Jed0vcela/MacroPicoV1/3D files/encoder handle.SLDPRT

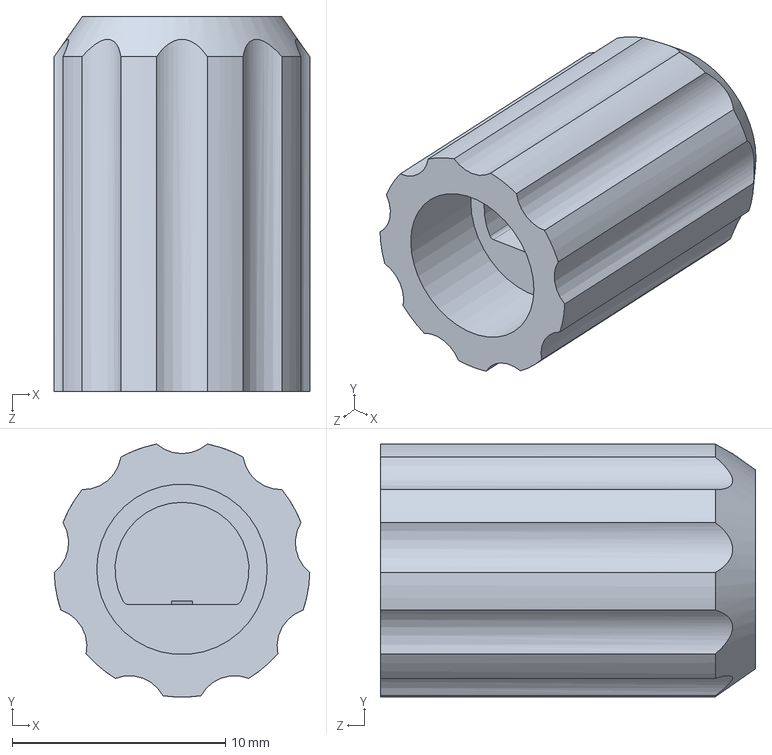
[picture p1: CAD file, 2025-07-16]
3D files/encoder handle.SLDPRT
12.0 x 11.9 x 17.6 mm
