Jed0vcela/MacroPicoV1/3D files/case bottom^Error2025Assem2.STL

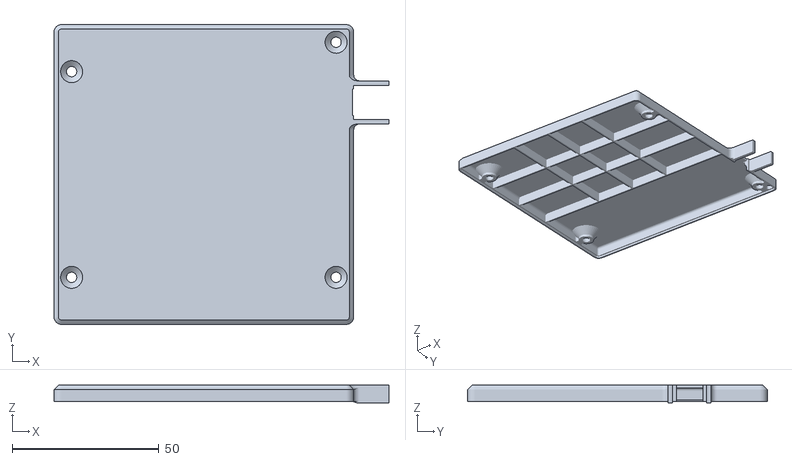
[picture p2: CAD file, 2025-07-16]
3D files/case bottom^Error2025Assem2.STL
114.0 x 102.0 x 6.00
