Jed0vcela/MacroPicoV1/3D files/switch soldering holder.SLDPRT

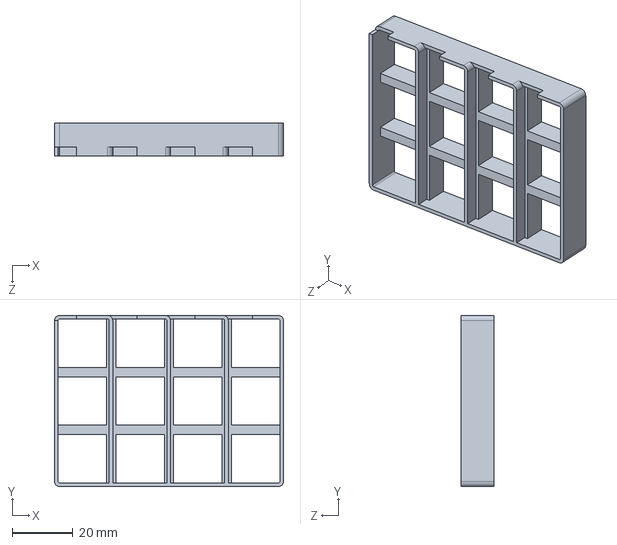
[picture p3: CAD file, 2025-07-16]
3D files/switch soldering holder.SLDPRT
75.5 x 56.5 x 11.0 mm
