Jed0vcela/MacroPicoV1/3D files/usb cable.SLDPRT

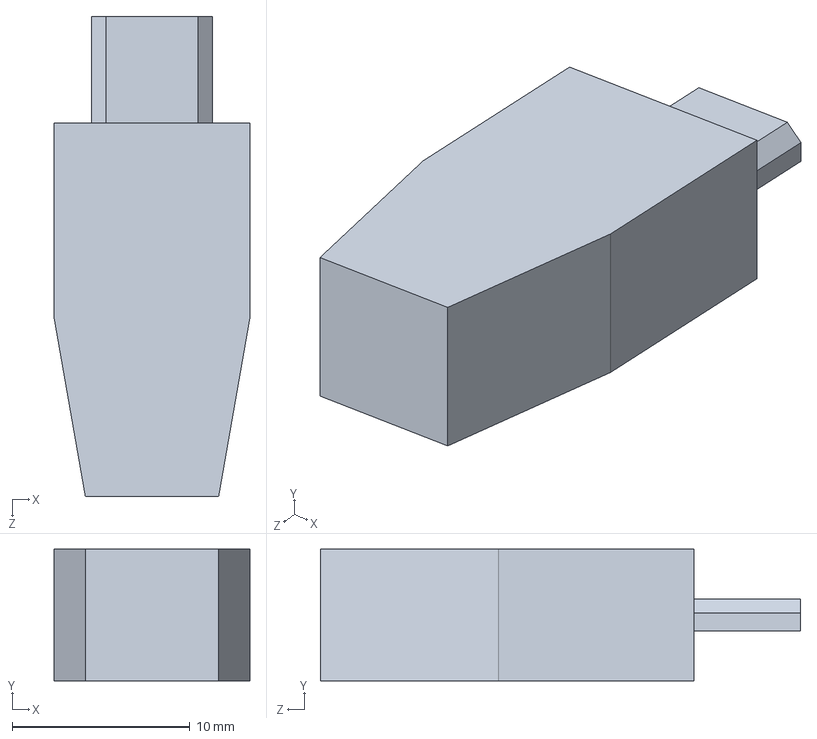
[picture p4: CAD file, 2025-07-16]
3D files/usb cable.SLDPRT
11.0 x 7.40 x 27.0 mm
