Jed0vcela/MacroPicoV1/3D files/button handle v2.SLDPRT

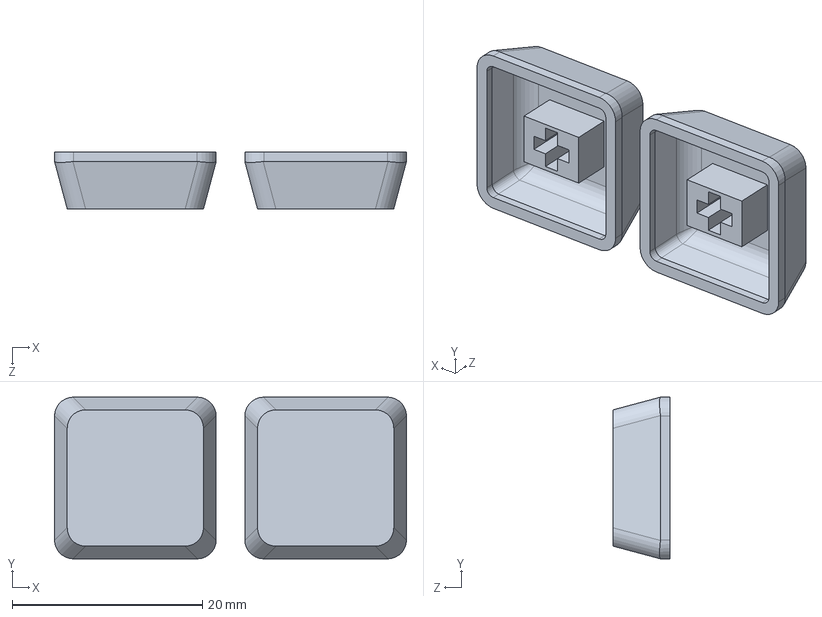
[picture p5: CAD file, 2025-07-16]
3D files/button handle v2.SLDPRT
37.0 x 17.0 x 6.00 mm
