Jed0vcela/MacroPicoV1/3D files/case top^Error2025Assem1.STL

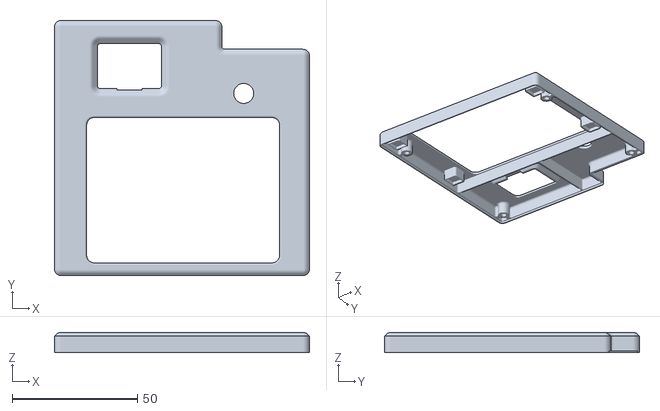
[picture p7: CAD file, 2025-07-16]
3D files/case top^Error2025Assem1.STL
102.0 x 102.0 x 8.00
