Jed0vcela/MacroPicoV1/3D files/drone servo detach part v1.SLDPRT

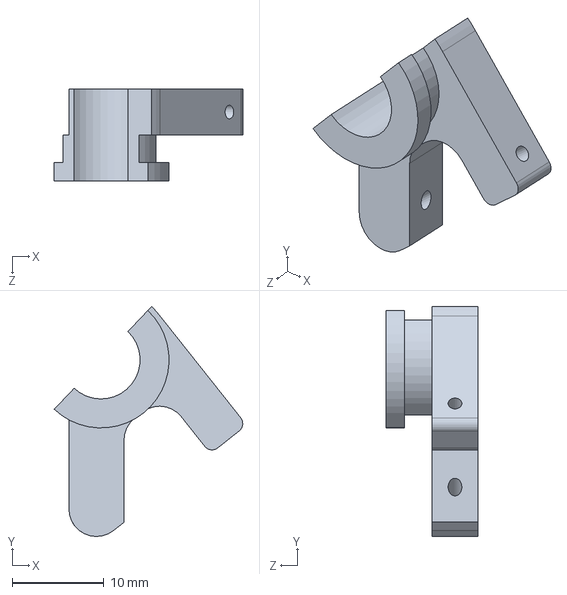
[picture p8: CAD file, 2025-07-16]
3D files/drone servo detach part v1.SLDPRT
20.5 x 25.0 x 10.0 mm
