Jed0vcela/MacroPicoV1/(list of files, cad)

Other CAD files:
KiCad files/PicoW.SLDASM
KiCad files/SSD1306_OLED_Display(128x64).SLDASM
KiCad files/board.SLDPRT
KiCad files/SW_Cherry_MX_PCB.SLDPRT
KiCad files/pin_header.SLDPRT
KiCad files/SOT-23_XC6206 v3.SLDPRT
KiCad files/error_via.SLDPRT
KiCad files/DSUB-9_Socket_Horizontal_P2.77x2.84mm_EdgePinOffset4.94mm_Housed_MountingHolesOffset4.94mm.SLDPRT
KiCad files/LED_WS2812B_PLCC4_5.0x5.0mm_P3.2mm.SLDPRT
KiCad files/D_MiniMELF.SLDPRT
KiCad files/flat_cable.SLDPRT
KiCad files/error_copper.SLDPRT
KiCad files/error_pad.SLDPRT
KiCad files/C_0805_2012Metric.SLDPRT
KiCad files/PEC12R-4220F-S0024.SLDPRT
KiCad files/error 1.54.1.SLDPRT
KiCad files/472_smd_resistor.SLDPRT
KiCad files/screen.SLDPRT
KiCad files/error 1.54.2.SLDPRT
KiCad files/error_PCB.SLDPRT
KiCad files/smd_capacitor.SLDPRT
KiCad files/error_silkscreen.SLDPRT
KiCad files/SOT-23-6.SLDPRT
KiCad files/t4_smd_diode.SLDPRT
KiCad files/914_smd_resistor.SLDPRT
KiCad files/soldering.SLDPRT
3D files/button handle v1.SLDPRT
3D files/button handle v2.STL
3D files/drone servo detach part v1.STL
3D files/encoder handle.STL
3D files/switch soldering holder.STL
KiCad files/472_smd_resistor (1).SLDPRT
KiCad files/smd_capacitor (1).SLDPRT
KiCad files/smd_capacitor (2).SLDPRT
KiCad files/smd_capacitor (3).SLDPRT
KiCad files/smd_capacitor (4).SLDPRT
KiCad files/smd_capacitor (5).SLDPRT
KiCad files/smd_capacitor (6).SLDPRT
KiCad files/smd_capacitor (7).SLDPRT
