Jed0vcela/MacroPicoV1/KiCad files/error.pdf

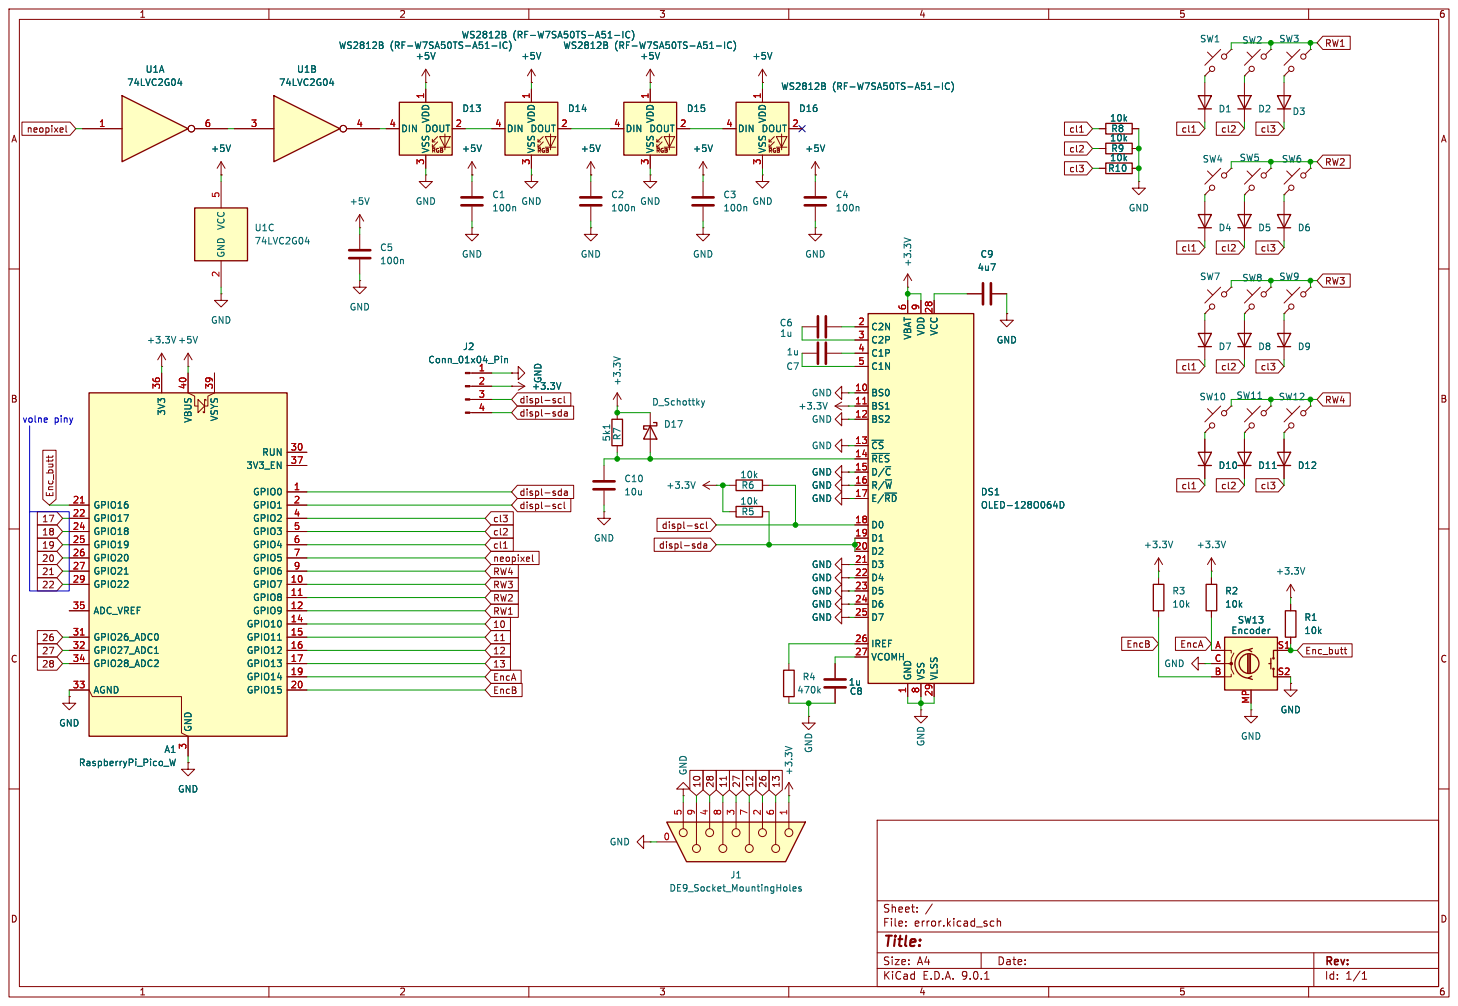
[picture p9: page 1]

3 DOUT 2 +5V +5V +5V D13 WS2812B (RF-W7SA50TS-A51-IC) DIN 4 VDD

3 DOUT 2 +5V +5V D15 WS2812B (RF-W7SA50TS-A51-IC) DIN 4 VDD

3 DOUT 2 D16 WS2812B (RF-W7SA50TS-A51-IC) GND

3 3V3 36 GPIO16 21 GPIO17 22 GPIO18 24 GPIO19 25 GPIO20 26 GPIO21 27 GPIO22 29 ADC_VREF 35 GPIO26_ADC0 31 GPIO27_ADC1 32 GPIO28_ADC2 34 AGND 33 GND GND GND

+3.3VGND GND GND GND GND
1u GND GND GND GND GND GND GND

Id: 1/1 Title: File: error.kicad_sch Sheet: /
