Jed0vcela/MacroPicoV1/KiCad files/error.kicad_pcb

## KiCad design KiCad files/error.kicad_pcb (2025-07-16)

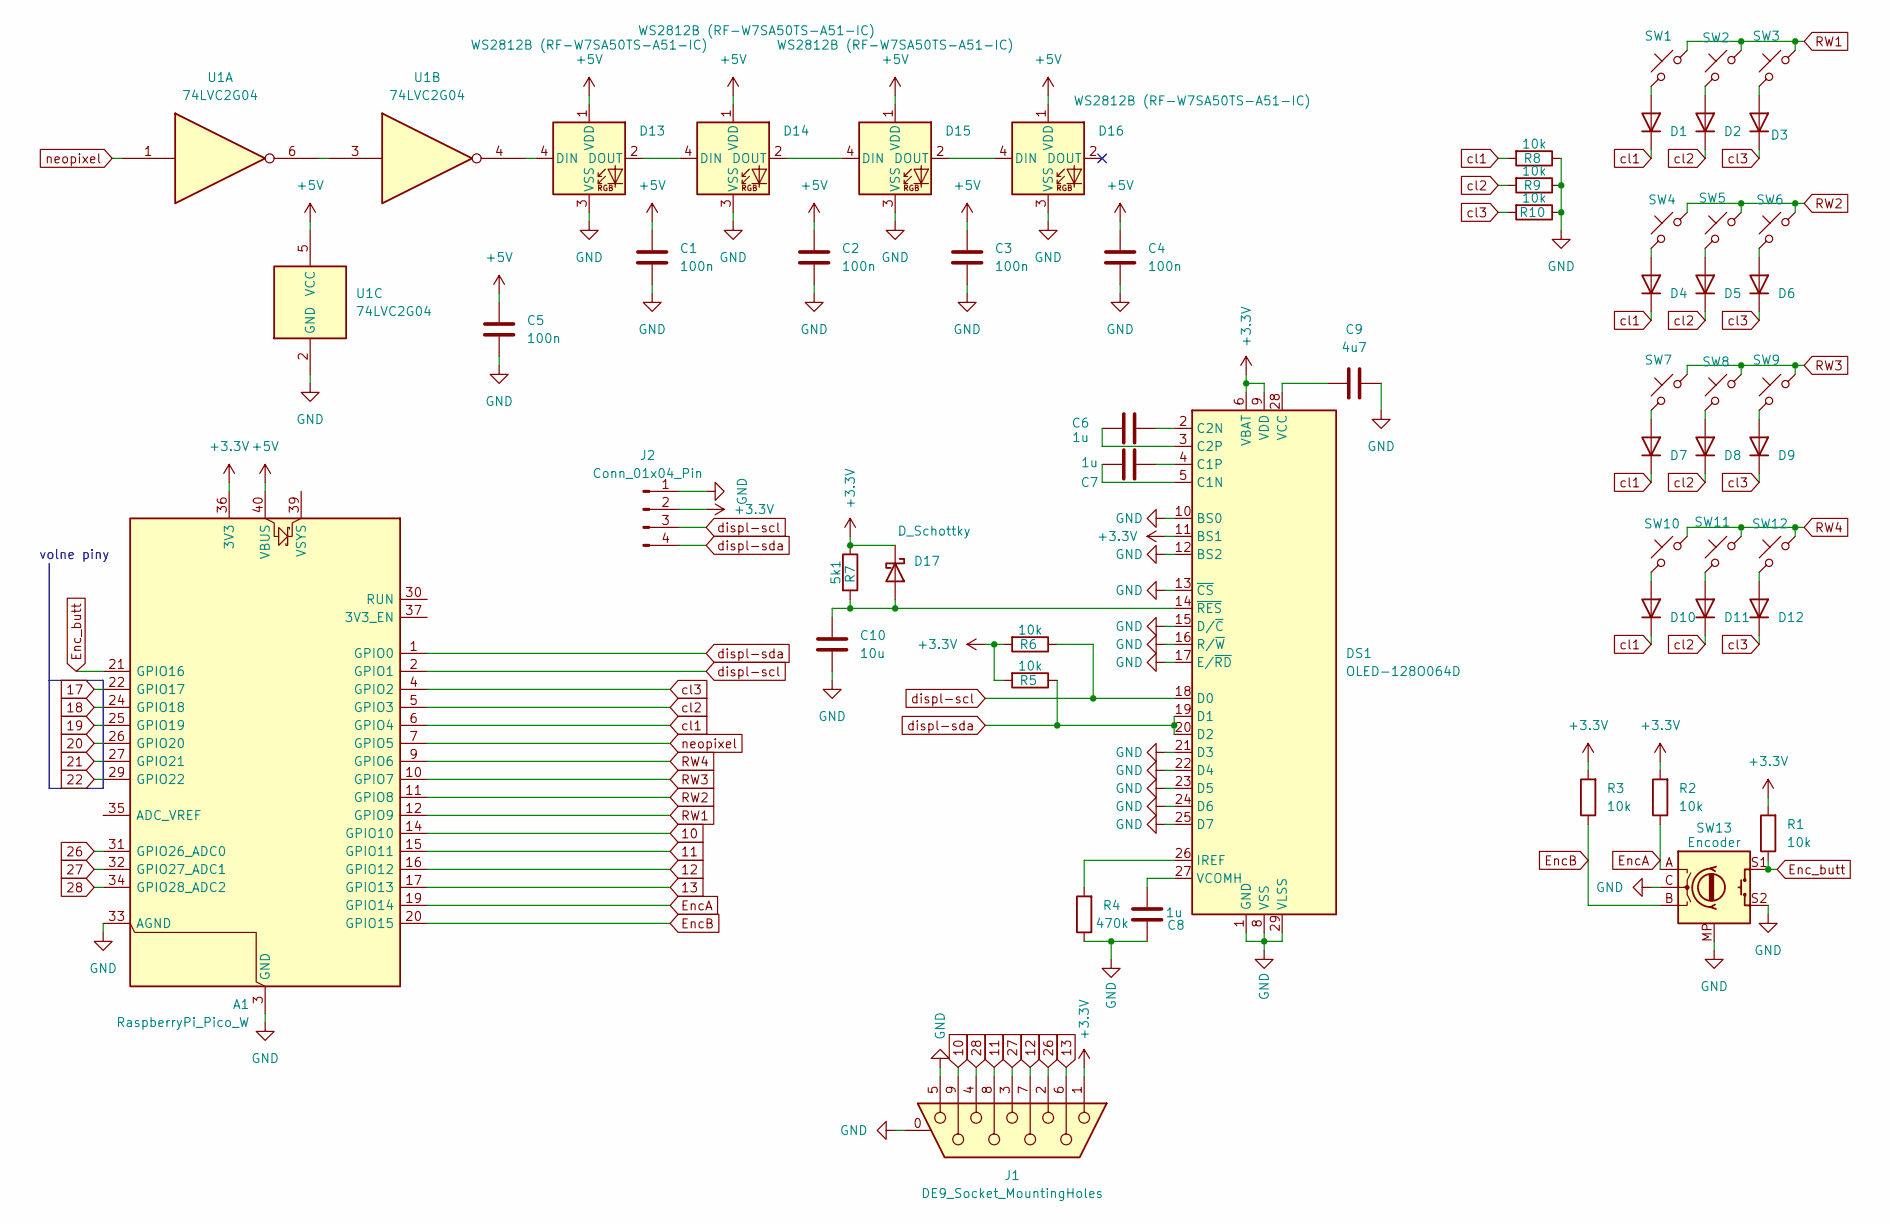
[picture p10: schematic error.kicad_sch]

Parts:
A1: RaspberryPi_Pico_W; RaspberryPi_Pico_Common_SMD
C1, C2, C3, C4, C5: 100n; C_0805_2012Metric_Pad1.18x1.45mm_HandSolder
C6, C7, C8: 1u; C_0805_2012Metric_Pad1.18x1.45mm_HandSolder
C9: 4u7; C_0805_2012Metric_Pad1.18x1.45mm_HandSolder
C10: 10u; C_0805_2012Metric_Pad1.18x1.45mm_HandSolder
D1, D2, D3, D4, D5, D6, D7, D8, D9, D10, D11, D12: D; D_MiniMELF
D13, D14, D15, D16: WS2812B (RF-W7SA50TS-A51-IC); LED_WS2812B_PLCC4_5.0x5.0mm_P3.2mm
D17: D_Schottky; D_MiniMELF
DS1: OLED-128O064D
J1: DE9_Socket_MountingHoles; DSUB-9_Socket_Horizontal_P2.77x2.84mm_EdgePinOffset4.94mm_H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
J2: Conn_01x04_Pin; PinHeader_1x04_P2.54mm_Vertical
R1, R2, R3, R5, R6, R8, R9, R10: 10k; C_0805_2012Metric_Pad1.18x1.45mm_HandSolder
R4: 470k; C_0805_2012Metric_Pad1.18x1.45mm_HandSolder
R7: 5k1; C_0805_2012Metric_Pad1.18x1.45mm_HandSolder
SW1, SW2, SW3, SW4, SW5, SW6, SW7, SW8, SW9, SW10, SW11, SW12: SW_Push_45deg; SW_Hybrid_Cherry_MX_Alps
SW13: Encoder; RotaryEncoder_Alps_EC11E-Switch_Vertical_H20mm_CircularMoun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
U1: 74LVC2G04; SOT-23-6_Handsoldering

Connections:
10: A1.14 (GPIO10), J1.9
11: A1.15 (GPIO11), J1.8
12: A1.16 (GPIO12), J1.7
13: A1.17 (GPIO13), J1.6
17: A1.22 (GPIO17)
18: A1.24 (GPIO18)
19: A1.25 (GPIO19)
20: A1.26 (GPIO20)
21: A1.27 (GPIO21)
22: A1.29 (GPIO22)
26: A1.31 (GPIO26_ADC0), J1.2
27: A1.32 (GPIO27_ADC1), J1.3
28: A1.34 (GPIO28_ADC2), J1.4
+3.3V: A1.36 (3V3), D17.1 (K), DS1.6 (VBAT), DS1.9 (VDD), DS1.11 (BS1), J1.1, J2.2, R1.2, R2.2, R3.2, R5.2, R6.2, R7.1
+5V: A1.40 (VBUS), C1.1, C2.1, C3.1, C4.1, C5.1, D13.1 (VDD), D14.1 (VDD), D15.1 (VDD), D16.1 (VDD), U1.5 (VCC)
EncA: A1.19 (GPIO14), R2.1, SW13.A
EncB: A1.20 (GPIO15), R3.1, SW13.B
Enc_butt: A1.21 (GPIO16), R1.1, SW13.S1
GND: A1.3 (GND), A1.8 (GND), A1.13 (GND), A1.18 (GND), A1.23 (GND), A1.28 (GND), A1.33 (AGND), A1.38 (GND), C1.2, C2.2, C3.2, C4.2, C5.2, C8.1, C9.2, C10.1, D13.3 (VSS), D14.3 (VSS), D15.3 (VSS), D16.3 (VSS), DS1.1 (GND), DS1.8 (VSS), DS1.10 (BS0), DS1.12 (BS2), DS1.13 (~CS), DS1.15 (D/~C), DS1.16 (R/~W), DS1.17 (E/~RD), DS1.21 (D3), DS1.22 (D4), DS1.23 (D5), DS1.24 (D6), DS1.25 (D7), DS1.29 (VLSS), DS1.30 (GND), J1.0 (PAD), J1.5, J2.1, R4.1, R8.1, R9.1, R10.1, SW13.C, SW13.MP, SW13.S2, U1.2 (GND)
unnamed: D1.2 (A), SW1.2
unnamed: D2.2 (A), SW2.2
unnamed: D3.2 (A), SW3.2
unnamed: D4.2 (A), SW4.2
unnamed: D5.2 (A), SW5.2
unnamed: D6.2 (A), SW6.2
unnamed: D7.2 (A), SW7.2
unnamed: D8.2 (A), SW8.2
unnamed: D9.2 (A), SW9.2
unnamed: D10.2 (A), SW10.2
unnamed: D11.2 (A), SW11.2
unnamed: D12.2 (A), SW12.2
unnamed: D13.4 (DIN), U1.4
unnamed: D13.2 (DOUT), D14.4 (DIN)
unnamed: D14.2 (DOUT), D15.4 (DIN)
unnamed: D15.2 (DOUT), D16.4 (DIN)
unnamed: C10.2, D17.2 (A), DS1.14 (~RES), R7.2
unnamed: C7.1, DS1.5 (C1N)
unnamed: C7.2, DS1.4 (C1P)
unnamed: C6.2, DS1.2 (C2N)
unnamed: C6.1, DS1.3 (C2P)
unnamed: DS1.26 (IREF), R4.2
unnamed: C9.1, DS1.28 (VCC)
unnamed: C8.2, DS1.27 (VCOMH)
unnamed: U1.3, U1.6
RW1: A1.12 (GPIO9), SW1.1, SW2.1, SW3.1
RW2: A1.11 (GPIO8), SW4.1, SW5.1, SW6.1
RW3: A1.10 (GPIO7), SW7.1, SW8.1, SW9.1
RW4: A1.9 (GPIO6), SW10.1, SW11.1, SW12.1
cl1: A1.6 (GPIO4), D1.1 (K), D4.1 (K), D7.1 (K), D10.1 (K), R8.2
cl2: A1.5 (GPIO3), D2.1 (K), D5.1 (K), D8.1 (K), D11.1 (K), R9.2
cl3: A1.4 (GPIO2), D3.1 (K), D6.1 (K), D9.1 (K), D12.1 (K), R10.2
displ-scl: A1.2 (GPIO1), DS1.18 (D0), J2.3, R6.1
displ-sda: A1.1 (GPIO0), DS1.19 (D1), DS1.20 (D2), J2.4, R5.1
neopixel: A1.7 (GPIO5), U1.1

Notes on the sheet:
volne piny

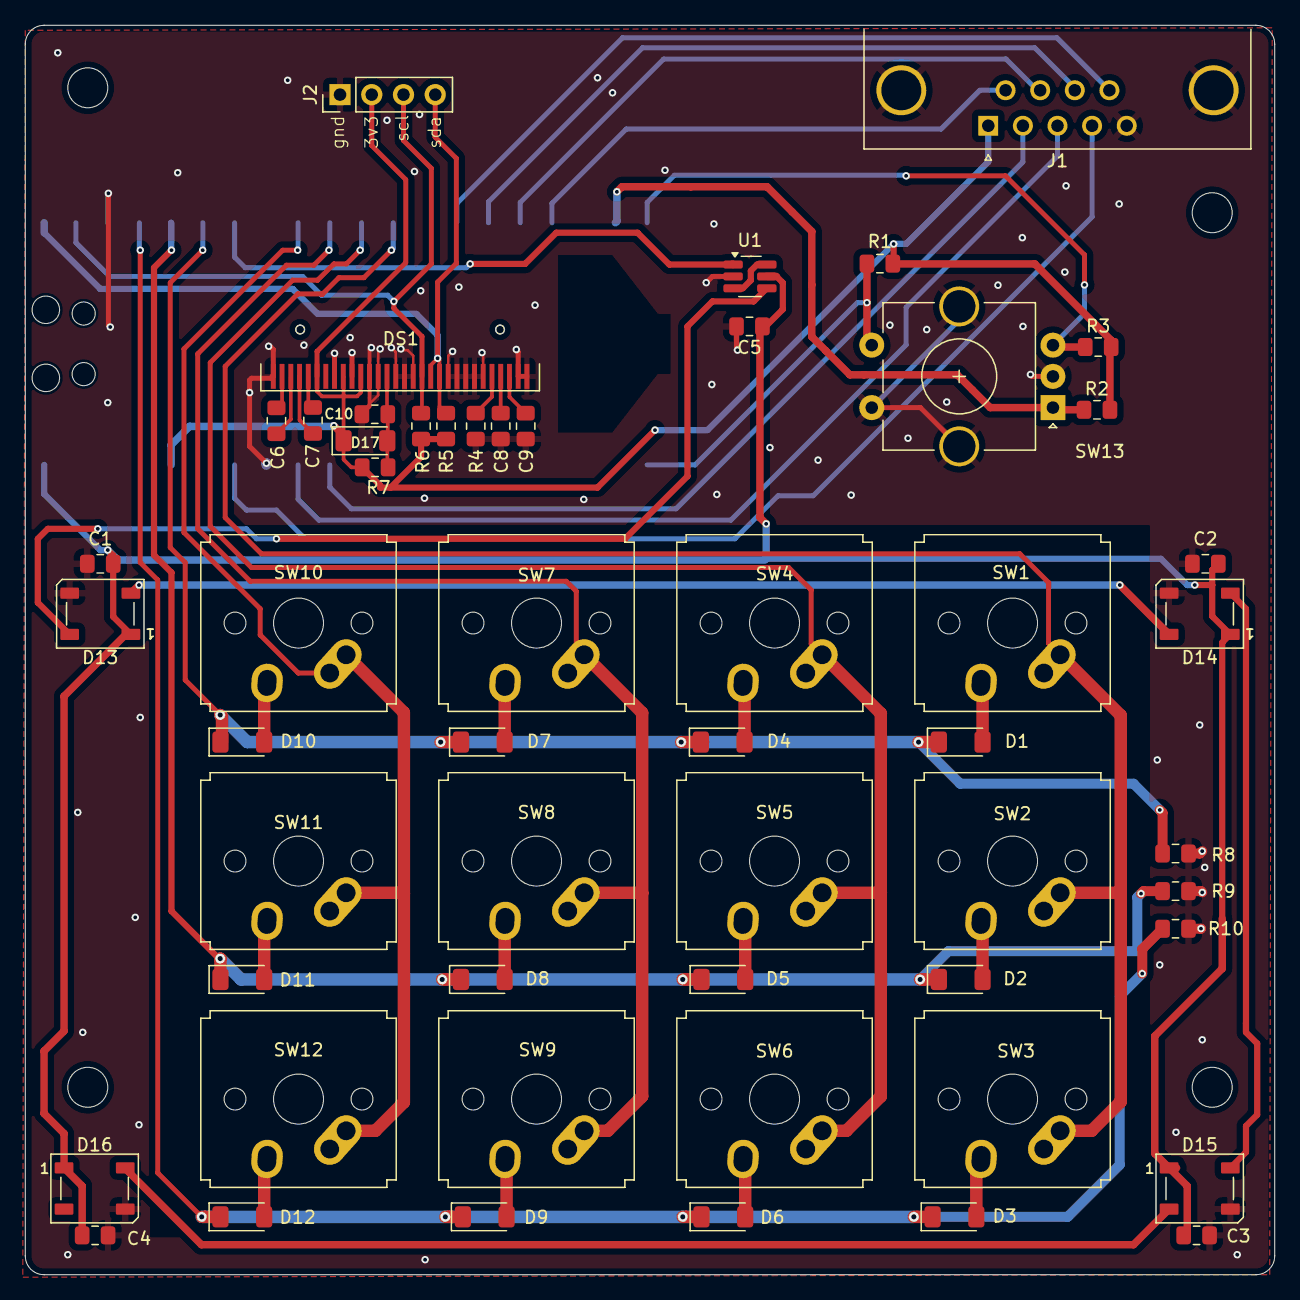
[picture p11: board error.kicad_pcb from above]

Board: 2 copper layers, 100.0 x 100.0 mm, 55 parts (1 on the bottom side), 48 nets.
